wangyang3c/new_patch/new3/protocol/SmartNIV Sensorpatch Protokoll_v3.0.docx

| | smartNIV Sensor-Patch Schnittstellen Spezifikation

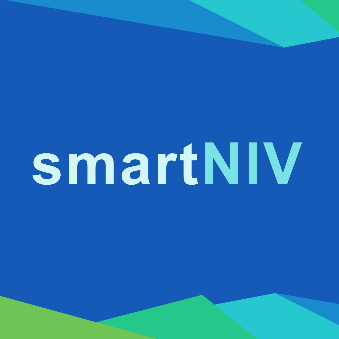
[picture p1: figure]

| Version Dokument-Tags | | 2.0 smartNIV
| Content | | Spezifikation des Kommunikationprotokolls zwischen der smartNIV software und dem Sensor-Patch Controller-PCB

Zuständigkeit | Name | Funktion
| msg DAVID GmbH | Implementierung SmartNIV Software
| Eugen Koch | Implementierung Controller-PCB

Änderungen | Author | Änderung | Datum | Version
| Dmitrij Drandarov | Initial | 27. Januar 2021 | 1.0
| Yang Wang | Protocol for new patch | 07. March 2022 | 2.0
| Yang Wang | Protocol for new patch | 18. Mai 2022 | 3.0

# Content

# 1 Ziel des Dokuments

Das Ziel des Dokuments ist es eine einheitliche und klare Spezifikation für die Kontrolle und das Abfragen des Sensor-Patches zu definieren.

# 2 Einleitung

Die Kommunikation zwischen den beiden Geräten findet über eine serielle Schnittstelle statt. Jede Nachricht wird von einem Frame ummantelt, der einen Header mit dem Start-Byte und der Identifikation des Befehls und einen Footer mit dem End-Byte beinhaltet. Auf Checksummen wurde verzichtet, um die hochfrequente Kommunikation möglichst performant zu halten.

# 3 Schnittstellen Konfiguration

Die serielle Schnittstelle nutzt folgende Einstellungen:

- Data bits: 8
- Stop bits: 1
- Flow control: -
- Parity: 1
- Baud rate: 230400

# 4 Frame

Jede Nachricht ist in einem Frame beinhaltet. Der Header beinhaltet den Start-Byte und die Identifikation des Befehls. Der Footer enthält das End-Byte. Für Daten, die mehrere Bytes spannen benutzen wir Big Endian.

Byte # | Name | Länge (Bytes)

Header
0 | Start-Byte (0x81) | 1
1 | Befehl-Byte | 1

Payload
2..n+1 | Befehl-Argumente / Antwort | N

Footer
n+2 | End-Byte (0x7E) | 1

Datentyp | Bedeutung
Uint8 | Einzelne Bytes sollen als unsigned 8-bit Integer interpretiert werden.
Uint16 | Zwei zusammenhängende Bytes sollen als Big Endian unsigned 16-bit Integer interpretiert werden.
Uint32 | Vier zusammenhängende Bytes sollen als Big Endian unsigned 32-bit Integer interpretiert werden.
ASCII | Einzelne Bytes sollen als ASCII Charaktere interpretiert werden.

# 5 Befehle

Jeder Befehl besitzt ein Befehl-Byte, das im Header des Frames der Anfrage und der Antwort beinhaltet werden muss. Der Befehl-Inhalt und die Antwort sind folgend in zwei Tabellen aufgeteilt. Zudem wird die Anzahl der Sensoren die Variable „n“ benutzt.

## 5.1 Test Übertragung

Es wird eine Testübertragung von der Hardware angefragt. Die Hardware antwortet mit einer ASCII Nachricht.

- Befehl-Byte: 0x01

### 5.1.1 Befehl-Argumente

### 5.1.2 Antwort

Byte # | Byte-Format | Name | Typ | Länge (Bytes)
0..4 | 0x54 0x65 0x73 0x74 0x00 | Test\0 (ASCII) | ASCII | 5

## 5.2 LED an-/Ausschalten

Es wird die LED, die auf dem Controller-PCB angebracht ist, an- oder ausgeschaltet.

- Befehl-Byte: 0x02

### 5.2.1 Befehl-Argumente

Byte # | Byte-Format | Name | Typ | Länge (Bytes)
0 | 0x00 / 0x01 | LED aus / LED an | uint8 | 1

### 5.2.2 Antwort

## 5.3 Sensordaten einmalig abfragen

Fragt mit den angegebenen Parametern einmalig Sensorwerte ab.

- Befehl-Byte: 0x03

### 5.3.1 Befehl-Argumente

Byte # | Byte-Format | Name | Typ | Länge (Bytes)
0..1 | 0x0000 – 0xFFFF | delay_switch (Big endian) | uint16 | 2
2..3 | 0x0000 – 0xFFFF | delay_meas (Big endian) | uint16 | 2
4..(4+n) | 0x00 – 0xFF | Resistance selection (High bit = input point index, low bit = output point index) | uint8 | 1

### 5.3.2 Antwort

Byte # | Byte-Format | Name | Typ | Länge (Bytes)
0..3 | 0x00000000 – 0xFFFFFFFF | Timestamp (Big endian) | uint32 | 4
4..(4+n*2) | 0x0000 – 0xFFFF | Sensor Werte (Big endian) | uint16 | n*2

## 5.4 Sensordaten kontinuierlich abfragen

Fragt mit den übergebenen Parametern kontinuierlich Sensorwerte ab.

- Befehl-Byte: 0x04

### 5.4.1 Befehl-Argumente

Byte # | Byte-Format | Name | Typ | Länge (Bytes)
0..1 | 0x0000 – 0xFFFF | delay_switch (Big endian) | uint16 | 2
2..3 | 0x0000 – 0xFFFF | delay_meas (Big endian) | uint16 | 2
4..(4+n) | 0x00 – 0xFF | Resistance selection (input - output) | uint8 | 1

### 5.4.2 Antwort

Byte # | Byte-Format | Name | Typ | Länge (Bytes)
0..3 | 0x00000000 – 0xFFFFFFFF | Timestamp (Big endian) | Uint32 | 4
4..(4+n*2) | 0x0000 – 0xFFFF | Sensor Werte (Big endian) | uint16 | n*2

## 5.5 Sensor-Offset automatisch setzen

Offset-Werte, wie sie zum Zeitpunkt der Messung sind, werden als Rückgabe-Wert zurückgegeben. Gibt den Spannungszustand des Patches zurück. Und gibt auch die Werte, also die Differenz an, die notwendig war, um die Spannung auf 0 zu setzen. D.h. danach sind sie 0. Wenn man also direkt danach nochmal messen würde, wäre das Ergebnis 36 mal 0.

- Befehl-Byte: 0x05

### 5.5.1 Befehl-Argumente

### 5.5.2 Antwort

## 5.6 SENSORDATEN MAXIMALER UMRECHNUNGSFAKTOR Setzen

- Befehl-Byte: 0x06

### 5.6.1 Befehl-Argumente

Byte # | Byte-Format | Name | Typ | Länge (Bytes)
0 | 0x00 – 0xFF | Faktor | uint8 | 1

### 5.6.2 Antwort

## 5.7 SensorDaten Kontinuierlich abfragen Stoppen

Stoppt die kontinuierliche Rückgabe von Sensorwerten.

- Befehl-Byte: 0x08

### 5.7.1 Befehl-Argumente

### 5.7.2 Antwort

# 6 Beispiel

Im Folgenden wir ein Beispiel für die erwartete Kommunikation beim Ausführen von Befehl „Sensordaten einmalig abfragen“ (0x03) gezeigt.

Legende:

- Frame: 0x81 0x01:
- Nachrichten-Inhalt: 0x30 0x01

## 6.1 Anfrage

Anfrage (Parameter):

- delay_swtich = 500
- delay_meas = 10
- Resistance selection = (0,1), (0,2), (0,3), (1,2), (1,3), (2,3)

Anfrage (Hex):

- 0x81 0x03 0x01 0xf4 0x00 0x32 0x01 0x02 0x03 0x12 0x13 0x23 0x7E

## 6.2 Antwort

Antwort gekürzt (Parameter):

- 1482 / 2076 / .. / 1446

Anfrage gekürzt (Hex):

- 0x81 0x03 0xCA 0x05 0xC1 0x08 .. 0x6A 0x05 0x7E

# A Glossary

Begriff | Beschreibung
delay_switch | Wartet x Mikrosekunden zwischen den einzelnen Sensormessungen.
delay_meas | Wartet x Millisekunden zwischenzwei Gesamtmessungen (alle Sensoren).

Version 1.0 smartNIV Draft Seite 6 von 9

SmartNIVLöwenstein Medical & Co. KG Sensor-Patch Smart NIV Interface Specification Sensor-Patch Schnittstellen Spezifikation
