wangyang3c/new_patch/new3/getting_started.pptx

## Getting started into the project

- Yang Wang

Softwarefirma

## Overview

- How to build the system from scratch

## Step 1: Preparation

Hardware

Software

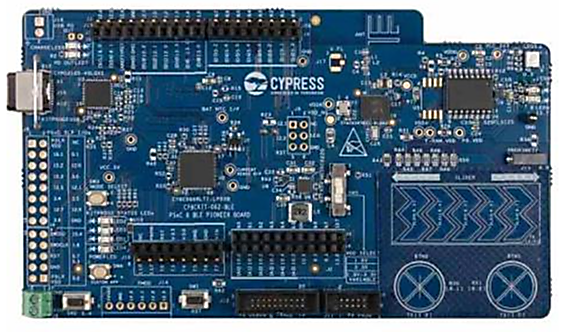
[picture p4: figure]

A new PSoC

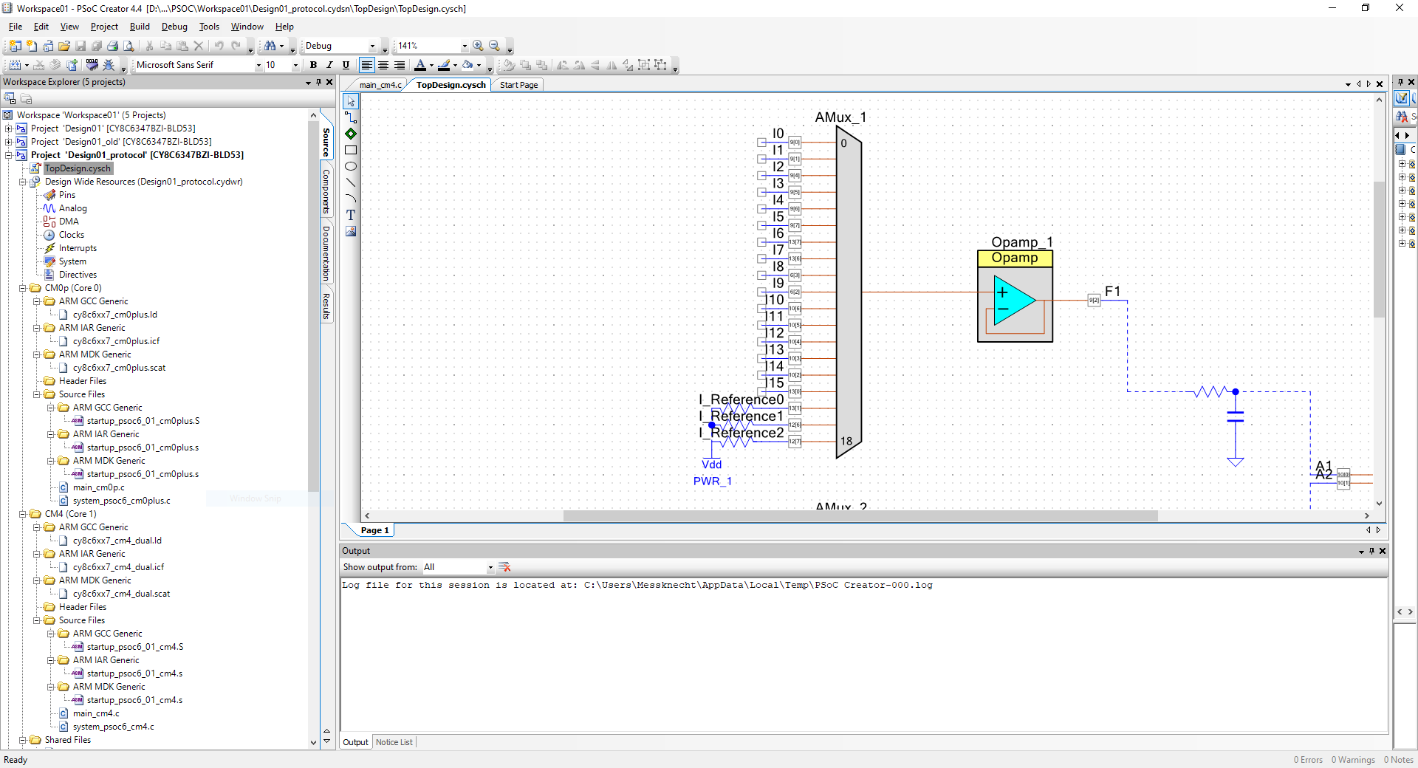
[picture p5: figure]

My PSoC project

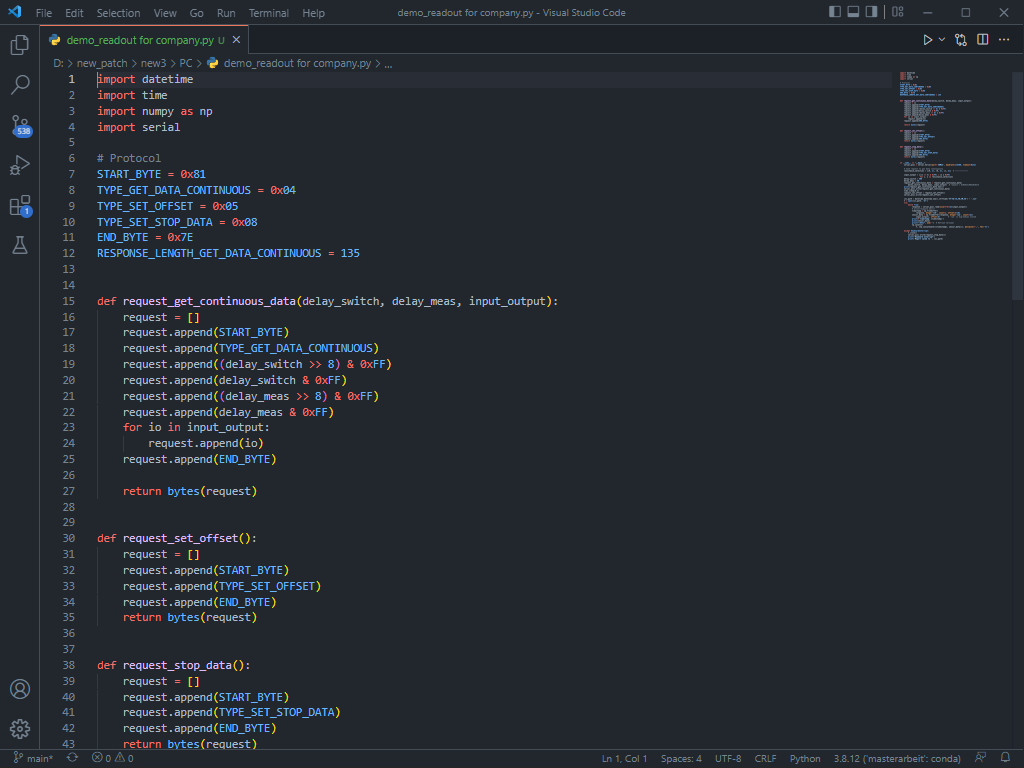
[picture p6: figure]

My PC program

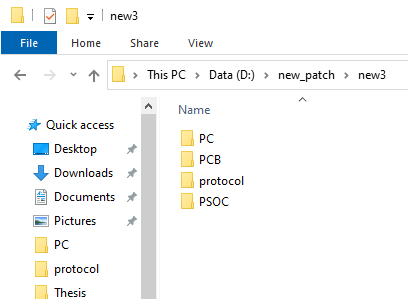
[picture p7: figure]
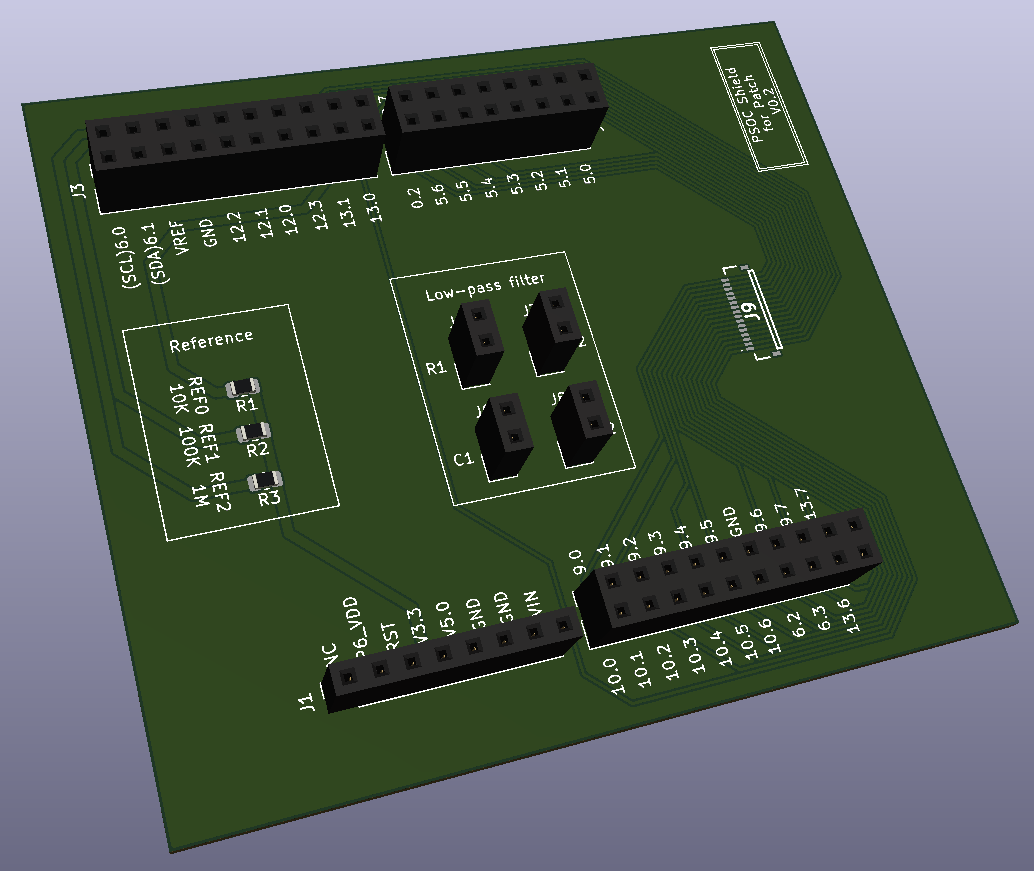
[picture p8: figure]

PCB board

Adapter

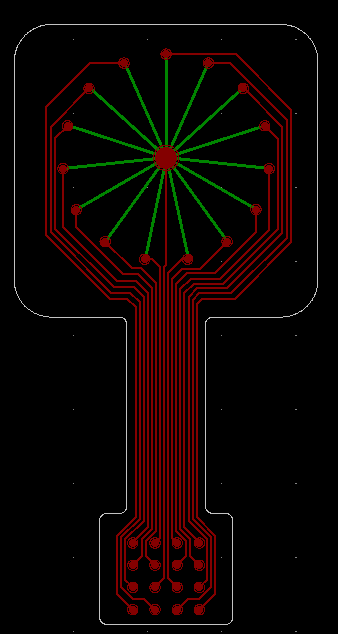
[picture p9: figure]

Patch

## Step 2: Solder the PSoC

PSoC project

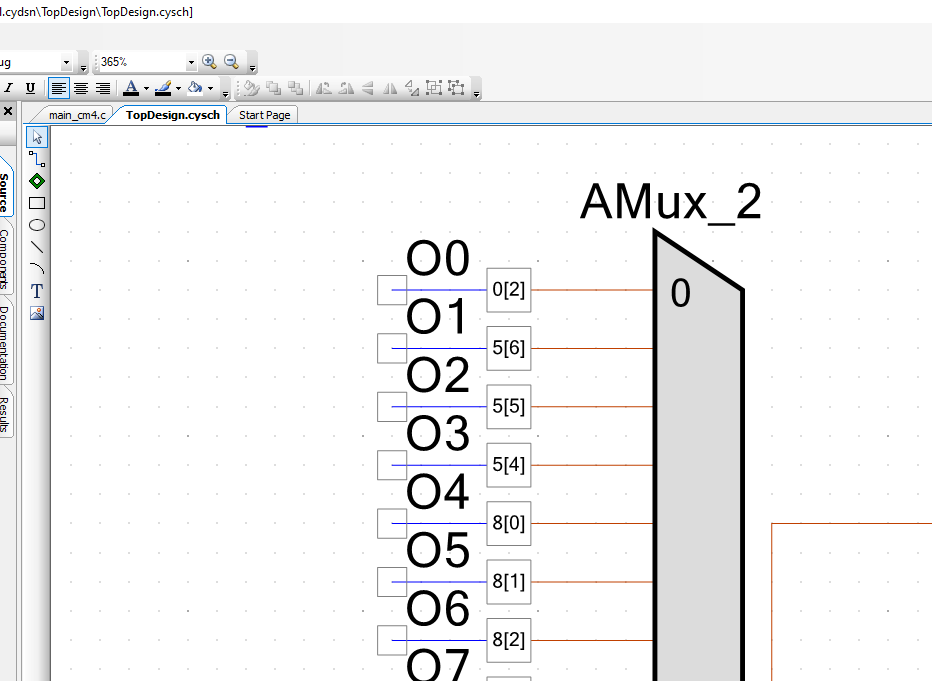
[picture p10: figure]

“PSoC 6 BLE Pioneer Kit Guide”, P12-16

Inaccessible

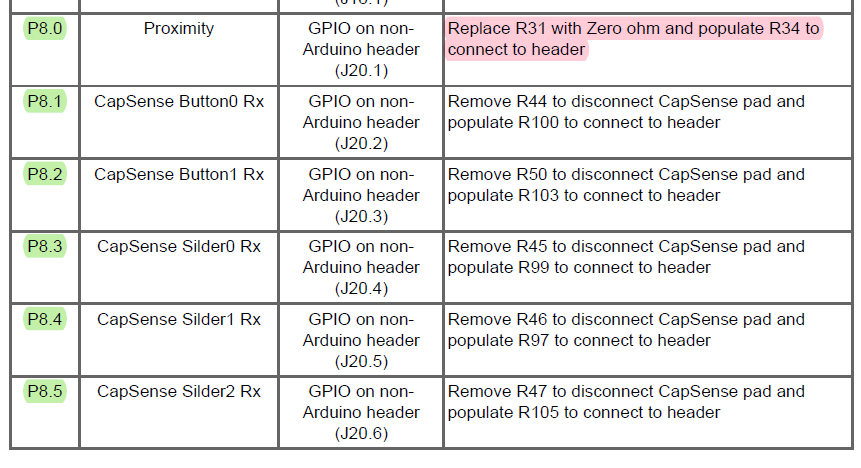
[picture p11: figure]

Check if the used pins can be accssed with the on-board headers (Accessible mostly when“GPIO on header”/“Arduino header” is primary function)

Solder the PSoC according to the description to make the pin accessable

Accessible

DO NOTHING

## Step 3: Assemble hardware

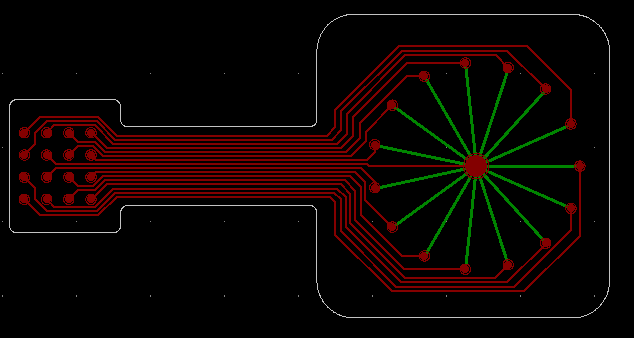
[picture p12: figure]

## Step 4: Flash the PSoC program

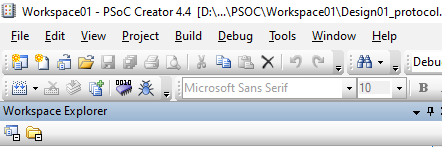
[picture p13: figure]

Click this button to flash the program to PSoC

## Step 5: Run PC program to start measurement

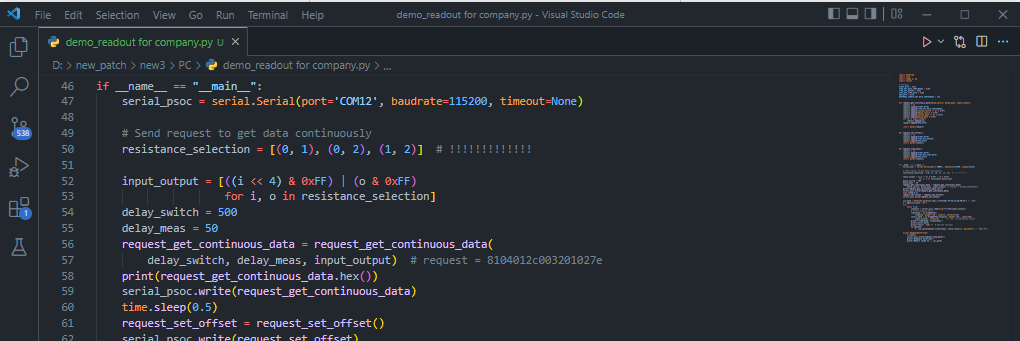
[picture p14: figure]

Configure the resistance you want measure

Format: [(INPUT_0, OUTPUT_0), (INPUT_1, OUTPUT_1), ….]

## Annex 1: The index of the points on adapter

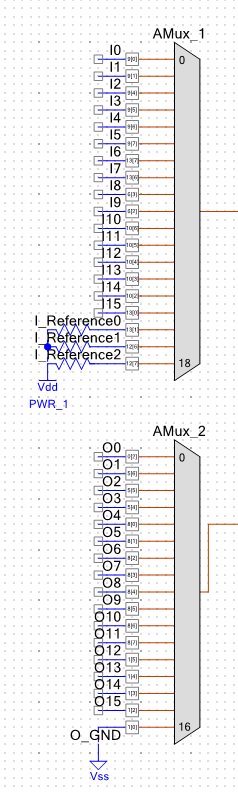
[picture p15: figure]

3 | 2 | 1 | 0
11 | 10 | 9 | 8
7 | 6 | 5 | 4
15 | 14 | 13 | 12

INPUT

OUTPUT

## Annex 2: Explanation of returned data

16-bit Code

0x7FFF (32767)

The retuned data is the relative resistance with respect to the initial resistance, e .g., R/(R_0) (R0 is set by the offset command).
We use 16 bits (0x0000 – 0xFFFF) to encode the relative resistance. (See left figure)
- Code 0x0000 – 0x8000 indicates current R <= R0
- Code 0x8000 – 0x7FFF indicates current R >= R0
K is the conversion limitation defined by user (can be changed by conversion factor setting command). It is defaultly set to 10. It means only the relative resistance between 0 and 10R0 is converted. The value out of range is mapped to 0x7FFF constantly .

0x8000 (32768)

0x0000 (0)

R/(R_0)

0

1

K
