wangyang3c/new_patch/new1/PCB/PSOC_shield/psoc_shield.kicad_pcb

## KiCad design new1/PCB/PSOC_shield/psoc_shield.kicad_pcb (2022-03-01)

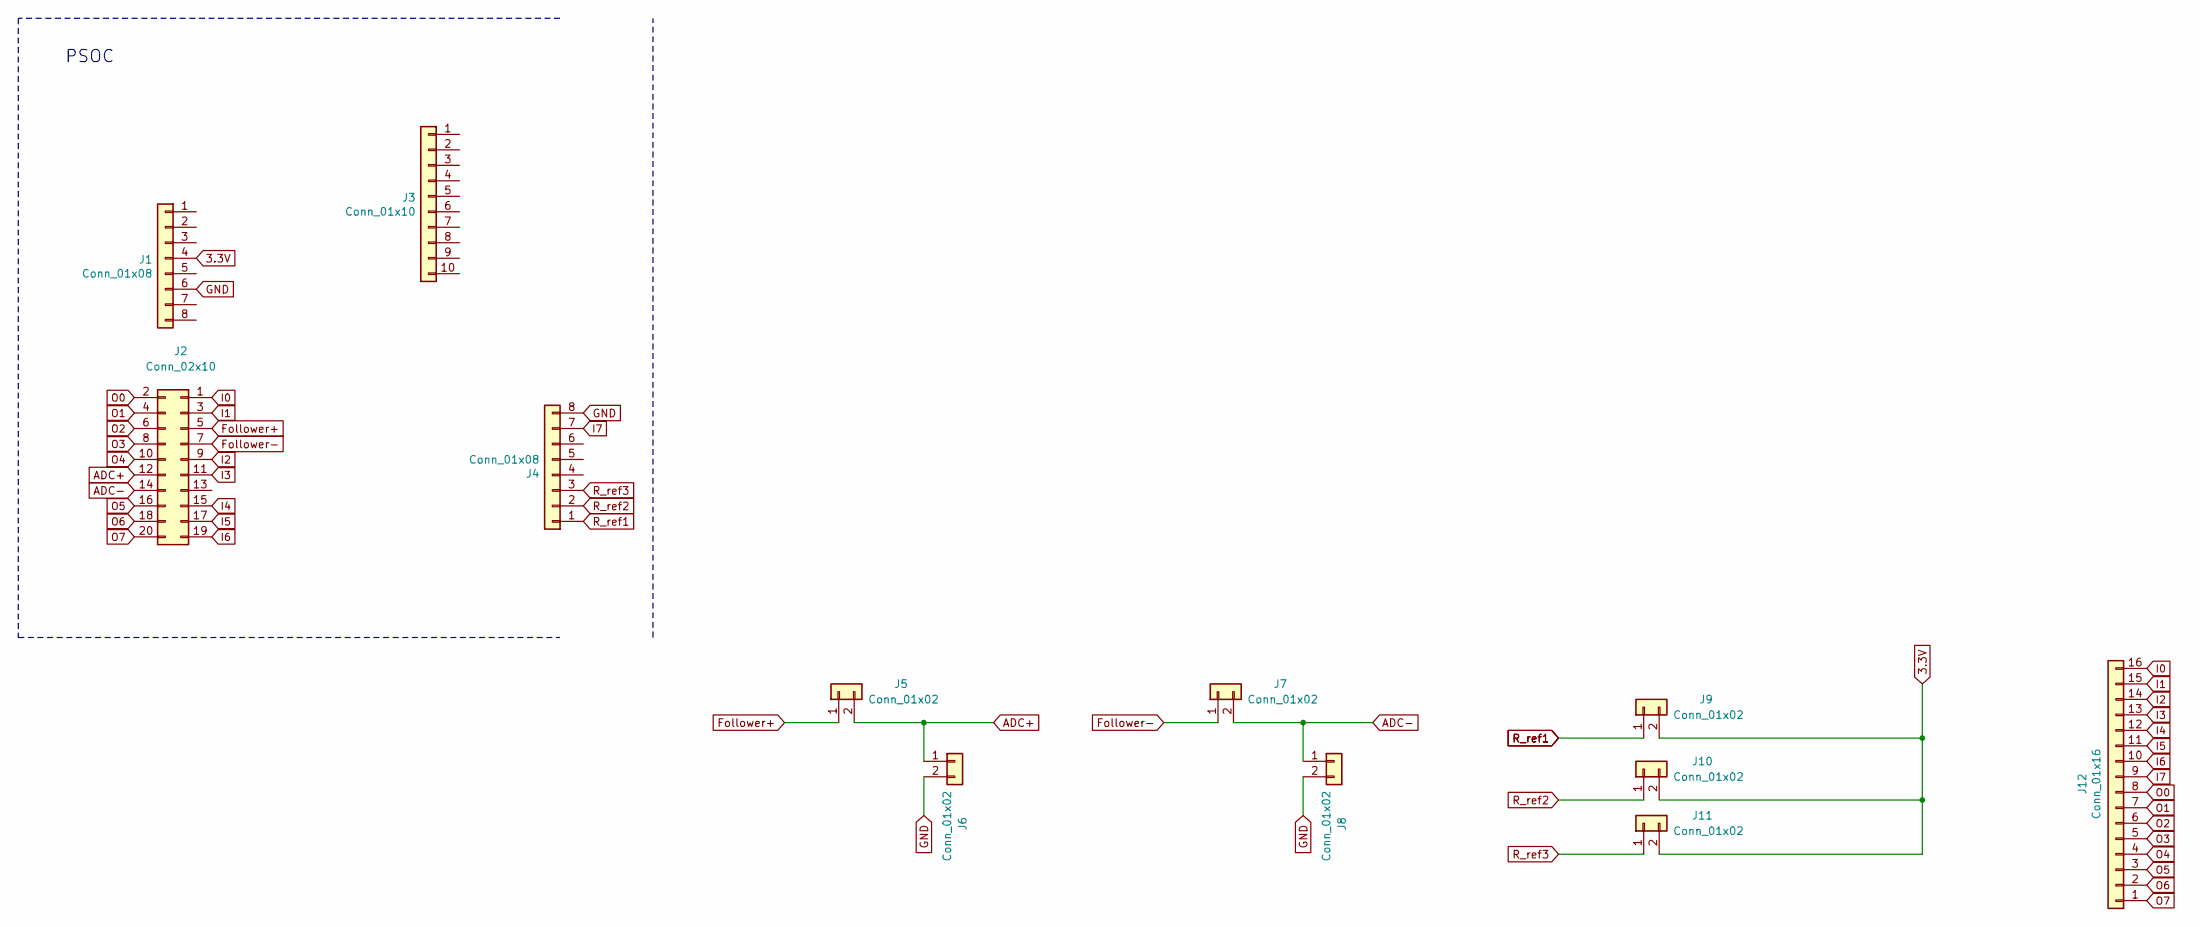
[picture p16: schematic psoc_shield.sch, Interface between PSOC and test platform]

Parts:
J1, J4: Conn_01x08; PinSocket_1x08_P2.54mm_Vertical
J2: Conn_02x10; PinSocket_2x10_P2.54mm_Vertical
J3: Conn_01x10; PinSocket_1x10_P2.54mm_Vertical
J5, J6, J7, J8, J9, J10, J11: Conn_01x02; PinSocket_1x02_P2.54mm_Vertical
J12: Conn_01x16; FH19SC16S05SH09

Connections:
3.3V: J1.4, J9.2, J10.2, J11.2
ADC+: J2.12, J5.2, J6.1
ADC-: J2.14, J7.2, J8.1
Follower+: J2.5, J5.1
Follower-: J2.7, J7.1
GND: J1.6, J4.8, J6.2, J8.2
I0: J2.1, J12.16
I1: J2.3, J12.15
I2: J2.9, J12.14
I3: J2.11, J12.13
I4: J2.15, J12.12
I5: J2.17, J12.11
I6: J2.19, J12.10
I7: J4.7, J12.9
O0: J2.2, J12.8
O1: J2.4, J12.7
O2: J2.6, J12.6
O3: J2.8, J12.5
O4: J2.10, J12.4
O5: J2.16, J12.3
O6: J2.18, J12.2
O7: J2.20, J12.1
R_ref1: J4.1, J9.1
R_ref2: J4.2, J10.1
R_ref3: J4.3, J11.1

Notes on the sheet:
PSOC

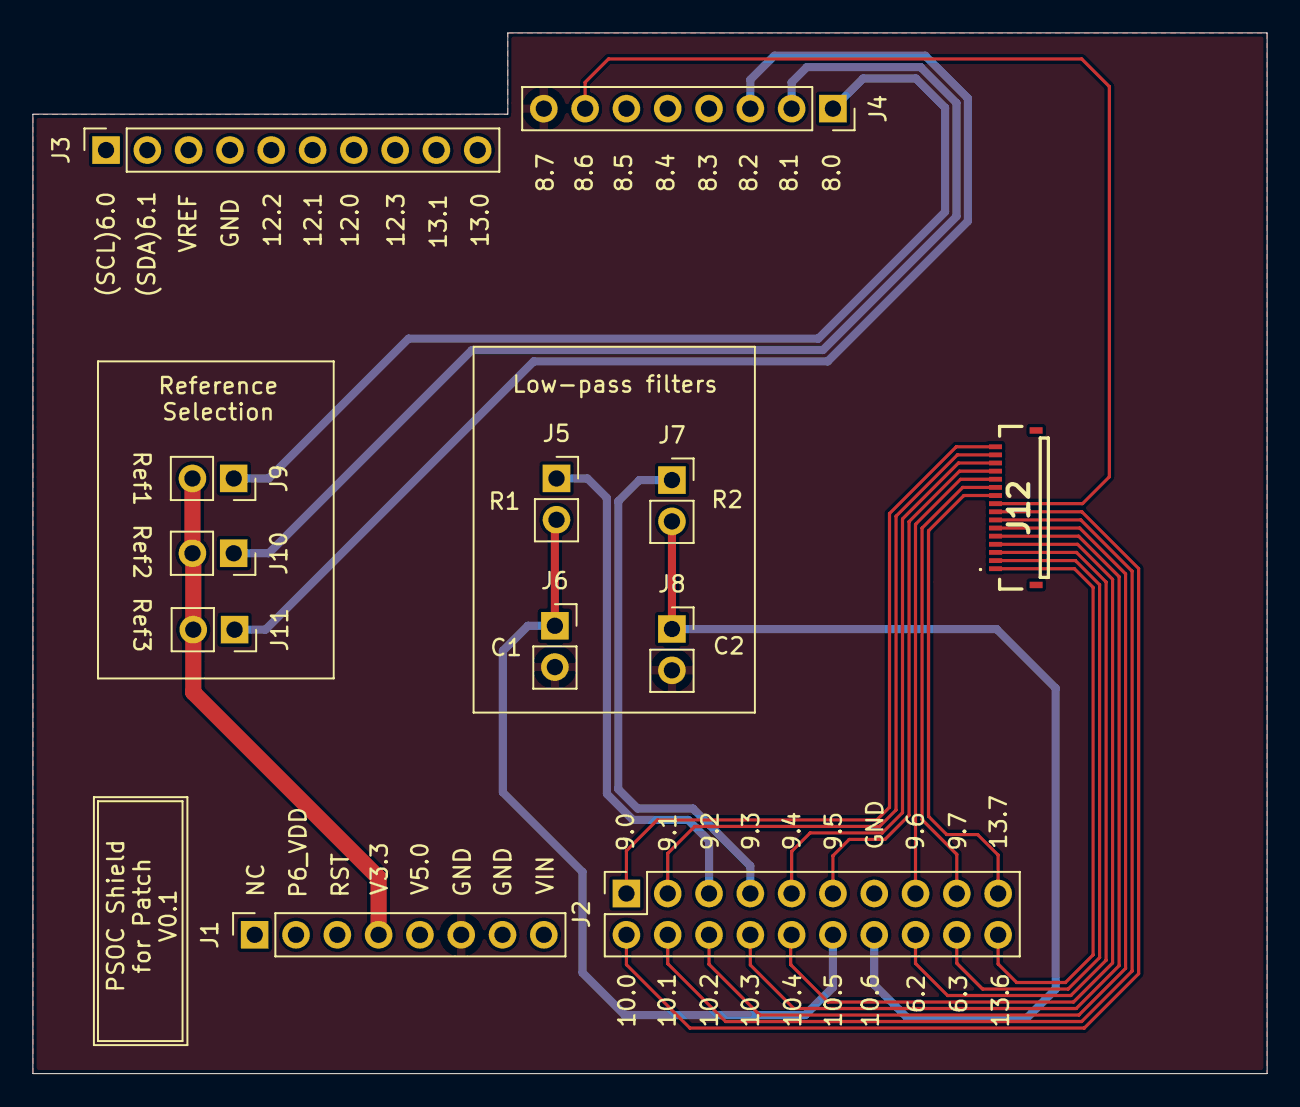
[picture p17: board new1/PCB/PSOC_shield/psoc_shield.kicad_pcb from above]

Board: 2 copper layers, 75.9 x 64.0 mm, 12 parts (0 on the bottom side), 25 nets.
