wangyang3c/new_patch/new3/PCB/PSOC_shield/psoc_shield.kicad_pcb

## KiCad design new3/PCB/PSOC_shield/psoc_shield.kicad_pcb (2022-05-23)

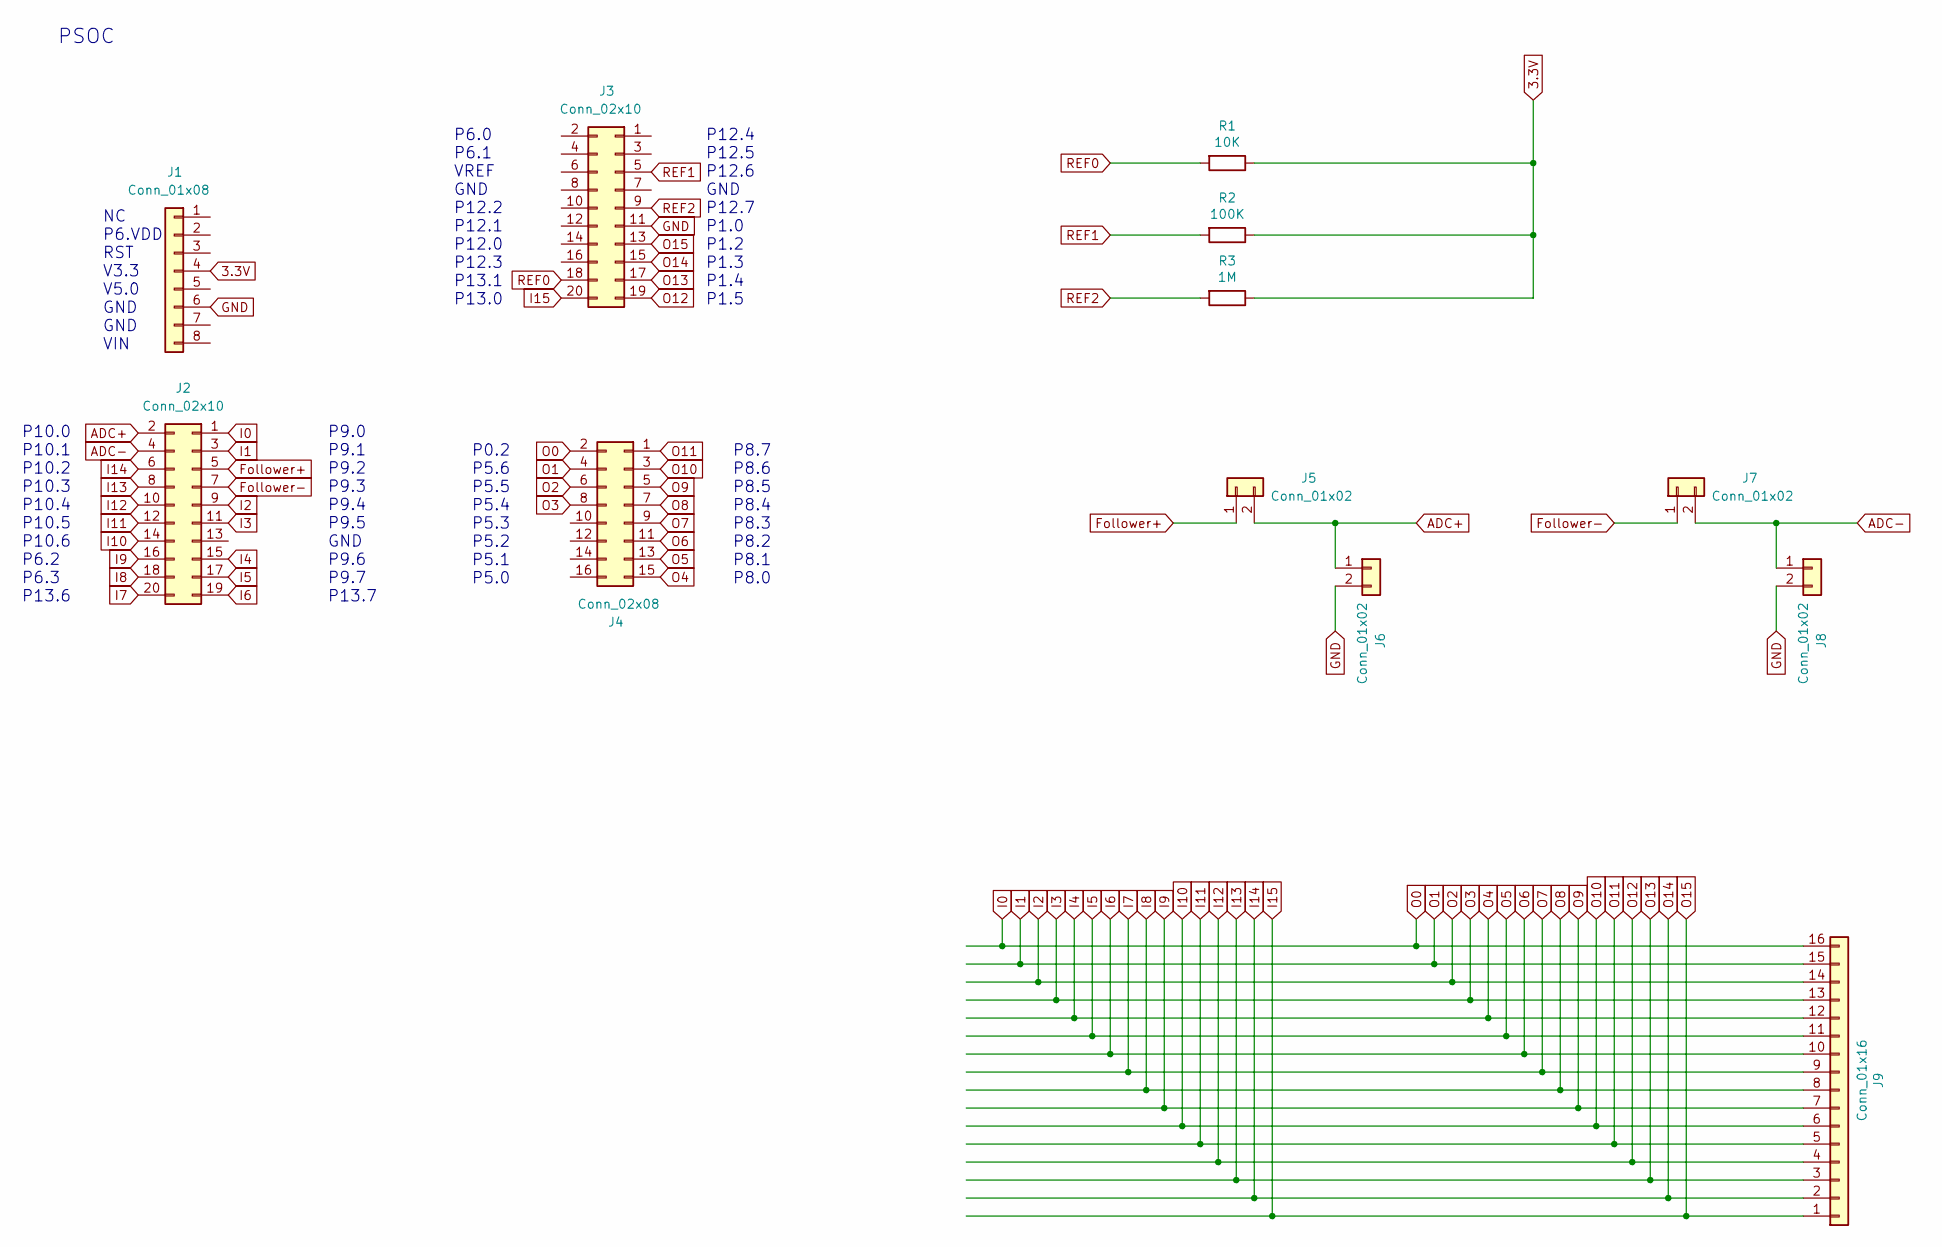
[picture p18: schematic psoc_shield.sch, Interface between PSOC and test platform]

Parts:
J1: Conn_01x08; PinSocket_1x08_P2.54mm_Vertical
J2, J3: Conn_02x10; PinSocket_2x10_P2.54mm_Vertical
J4: Conn_02x08; PinSocket_2x08_P2.54mm_Vertical
J5, J6, J7, J8: Conn_01x02; PinSocket_1x02_P2.54mm_Vertical
J9: Conn_01x16; FH19SC16S05SH09
R1: 10K; R_0805_2012Metric
R2: 100K; R_0805_2012Metric
R3: 1M; R_0805_2012Metric

Connections:
3.3V: J1.4, R1.1, R2.1, R3.1
ADC+: J2.2, J5.2, J6.1
ADC-: J2.4, J7.2, J8.1
Follower+: J2.5, J5.1
Follower-: J2.7, J7.1
GND: J1.6, J3.11, J6.2, J8.2
I0: J2.1, J4.2, J9.16
I1: J2.3, J4.4, J9.15
I2: J2.9, J4.6, J9.14
I3: J2.11, J4.8, J9.13
I4: J2.15, J4.15, J9.12
I5: J2.17, J4.13, J9.11
I6: J2.19, J4.11, J9.10
I7: J2.20, J4.9, J9.9
I8: J2.18, J4.7, J9.8
I9: J2.16, J4.5, J9.7
I10: J2.14, J4.3, J9.6
I11: J2.12, J4.1, J9.5
I12: J2.10, J3.19, J9.4
I13: J2.8, J3.17, J9.3
I14: J2.6, J3.15, J9.2
I15: J3.13, J3.20, J9.1
REF0: J3.18, R1.2
REF1: J3.5, R2.2
REF2: J3.9, R3.2

Notes on the sheet:
PSOC
P10.0 P10.1 P10.2 P10.3 P10.4 P10.5 P10.6 P6.2 P6.3 P13.6
P9.0 P9.1 P9.2 P9.3 P9.4 P9.5 GND P9.6 P9.7 P13.7
P8.7 P8.6 P8.5 P8.4 P8.3 P8.2 P8.1 P8.0
P0.2 P5.6 P5.5 P5.4 P5.3 P5.2 P5.1 P5.0
P12.4 P12.5 P12.6 GND P12.7 P1.0 P1.2 P1.3 P1.4 P1.5
P6.0 P6.1 VREF GND P12.2 P12.1 P12.0 P12.3 P13.1 P13.0
NC P6.VDD RST V3.3 V5.0 GND GND VIN

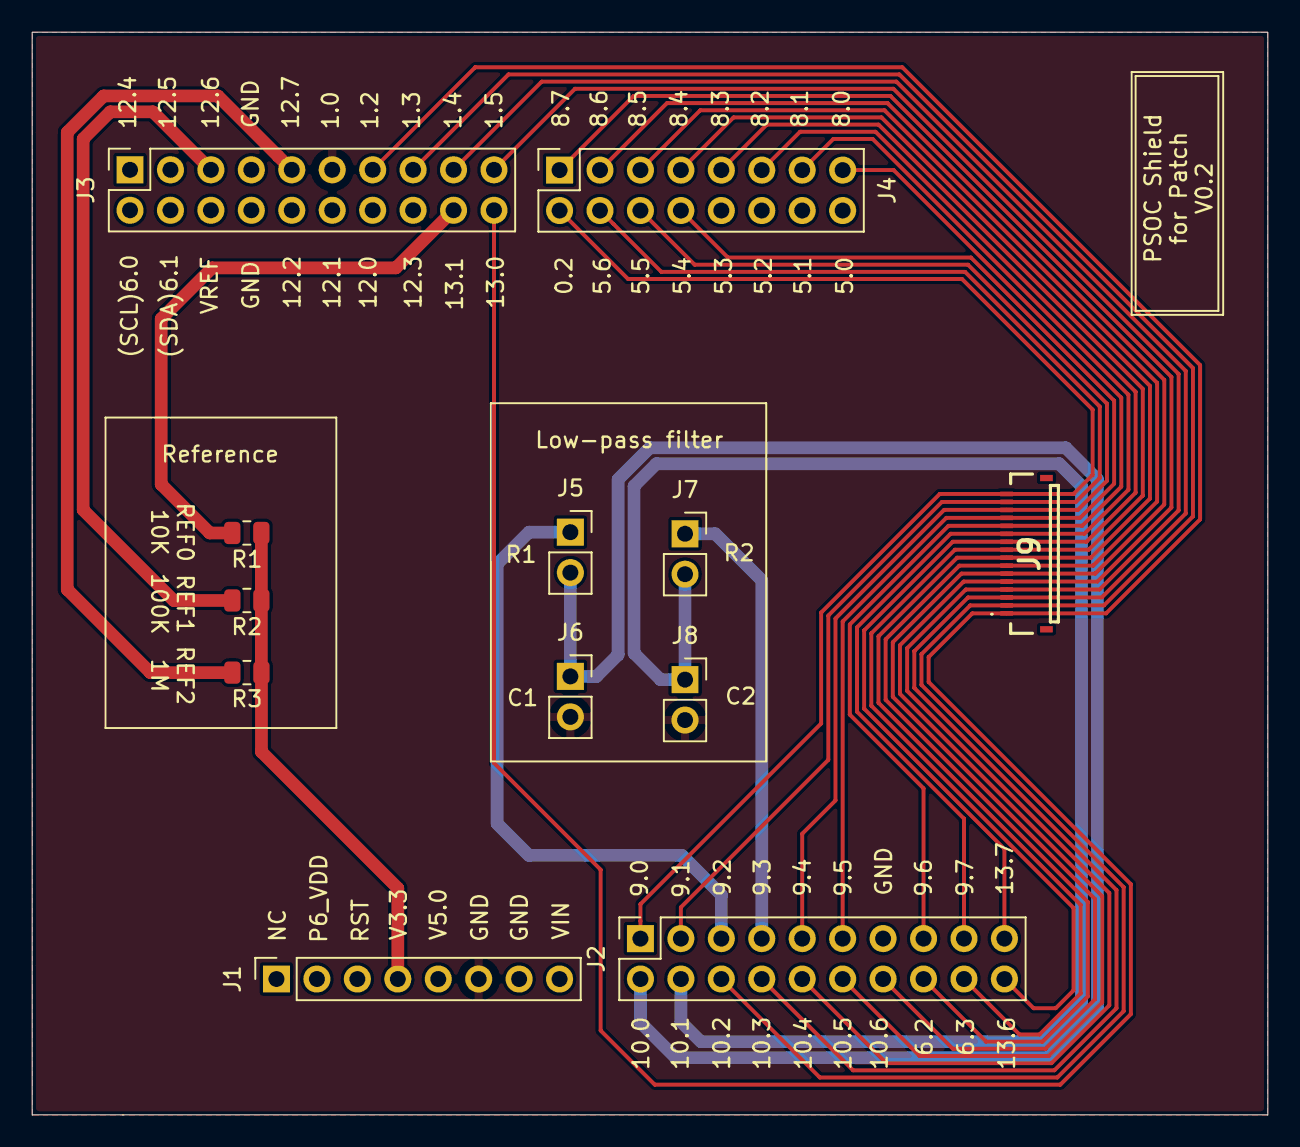
[picture p19: board new3/PCB/PSOC_shield/psoc_shield.kicad_pcb from above]

Board: 2 copper layers, 77.6 x 68.0 mm, 12 parts (0 on the bottom side), 25 nets.
