wangyang3c/new_patch/(commit log)

2022-03-01 Create project
    [Platine-Stecker - final.kicad_pcb, file619C41EF.sch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]
2022-03-05 implement resistance code
2022-03-06 fix resistance code
2022-05-23 add new3
    [2022-05-20_16_19_56.csv, 2022-05-20_16_22_52.csv, Neue Sensordesigns.kicad_pcb, Platine-Stecker - final.kicad_pcb, Sensor_Rahmen.kicad_pcb, file619C41EF.sch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]
